Manideep-GitHub/Clap-Detector-EDL/powersupply1.eps.tex

% XCircuit output "D:/Desktop/Sem 6/EE344 - Electronics Design Lab/MON-PCP-2-2/powersupply1.eps.tex" for LaTeX input from D:/Desktop/Sem 6/EE344 - Electronics Design Lab/MON-PCP-2-2/powersupply1.eps.ps
\def\putbox#1#2#3{\makebox[0in][l]{\makebox[#1][l]{}\raisebox{\baselineskip}[0in][0in]{\raisebox{#2}[0in][0in]{#3}}}}
\def\rightbox#1{\makebox[0in][r]{#1}}
\def\centbox#1{\makebox[0in]{#1}}
\def\topbox#1{\raisebox{-\baselineskip}[0in][0in]{#1}}
\def\midbox#1{\raisebox{-0.5\baselineskip}[0in][0in]{#1}}
\begin{flushleft}
\epsfig{file=D:/Desktop/Sem 6/EE344 - Electronics Design Lab/MON-PCP-2-2/powersupply1.eps.ps}\\
% translate x=528 y=476 scale 0.38
\putbox{4.47in}{1.79in}{Vref}%
\end{flushleft}
