Manideep-GitHub/Clap-Detector-EDL/powersupply.PNG

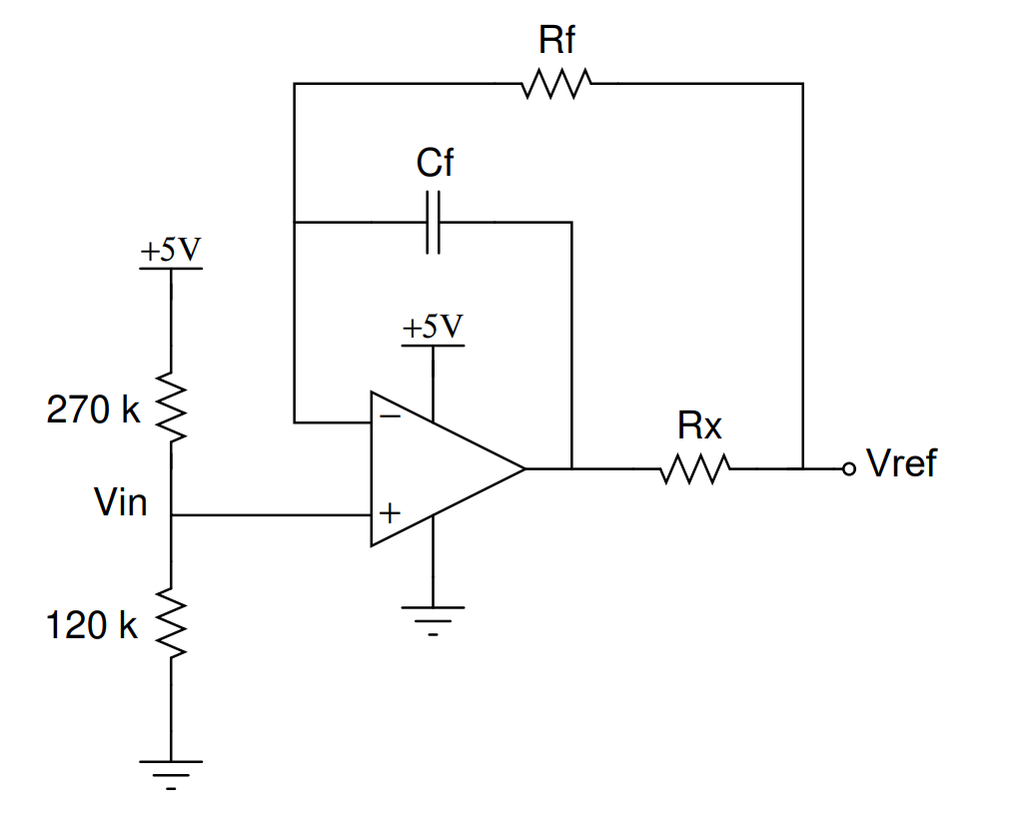
powersupply.PNG
