Manideep-GitHub/Clap-Detector-EDL/MON-PCP-2-2.pdf

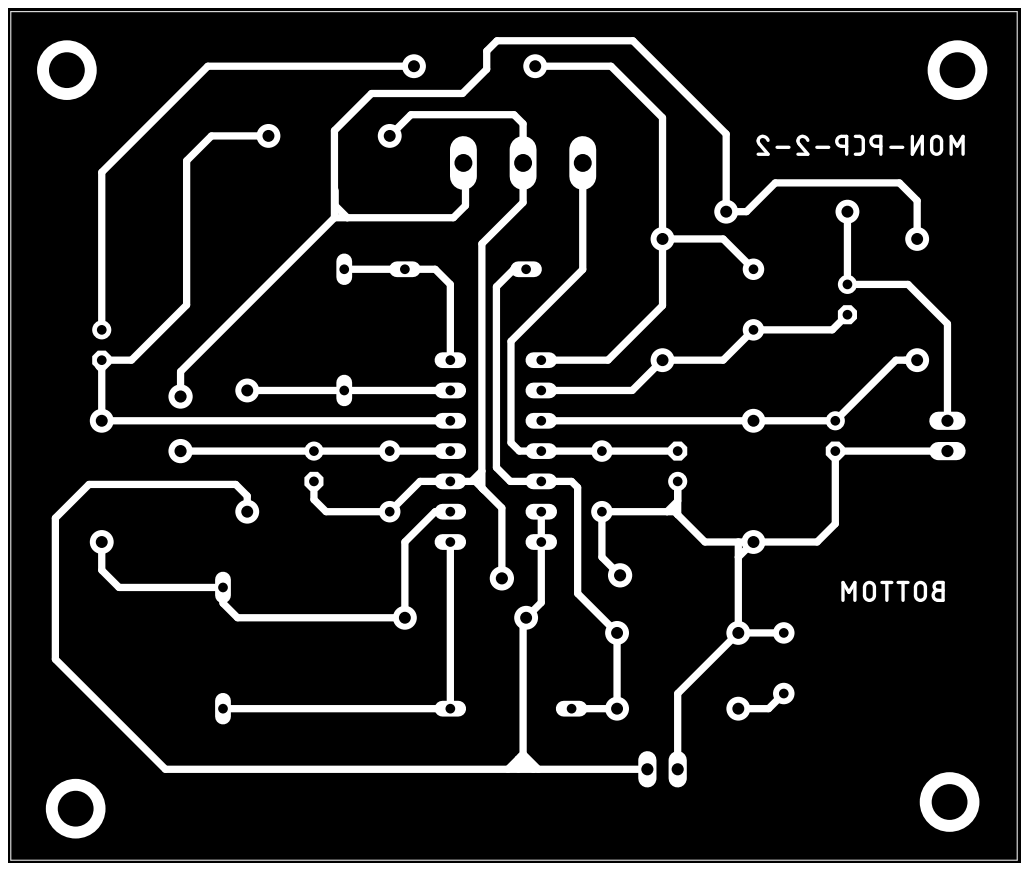
[picture p9: page 1]
