Manideep-GitHub/Clap-Detector-EDL/MON-PCP-2-2.brd

## EAGLE design MON-PCP-2-2.brd (2022-08-19)

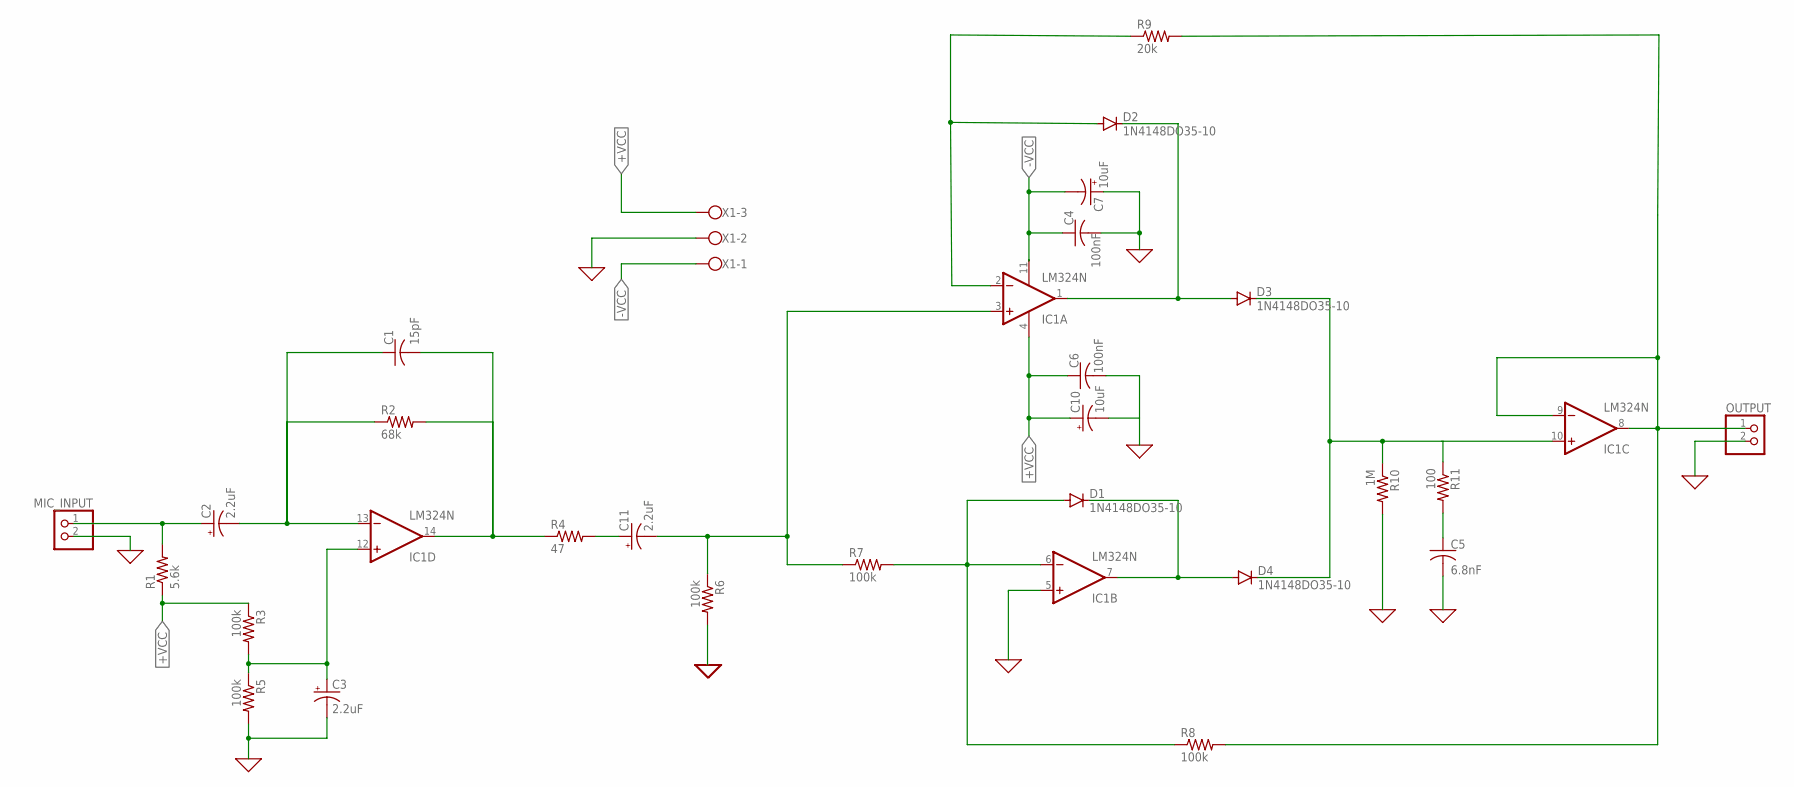
[picture p10: schematic MON-PCP-2-2.sch]

Parts:
C1: 15pF; C050-025X075
C2, C3, C11: 2.2uF; E2,5-7
C4, C6: 100nF; C050-025X075
C5: 6.8nF; C050-025X075
C7, C10: 10uF; E2,5-7
D1, D2, D3, D4: 1N4148DO35-10; DO35-10
IC1: LM324N; DIL14
MIC_INPUT: PINHD-1X2; 1X02
OUTPUT: PINHD-1X2; 1X02
R1: 5.6k; 0207/10
R2: 68k; 0207/10
R3, R5, R6, R7, R8: 100k; 0207/10
R4: 47; 0207/10
R9: 20k; 0207/10
R10: 1M; 0207/10
R11: 100; 0207/10
X1: W237-103

Connections:
0: C3.-, C4.2, C5.2, C6.2, C7.+, C10.-, IC1.5 (+IN), MIC_INPUT.2, OUTPUT.2, R5.2, R6.2, R10.2, X1.2
+VCC: C6.1, C10.+, IC1.4 (V+), R1.1, R3.1, X1.3
-VCC: C4.1, C7.-, IC1.11 (V-), X1.1
unnamed: D1.A, IC1.6 (-IN), R7.2, R8.1
unnamed: C3.+, IC1.12 (+IN), R3.2, R5.1
unnamed: C1.1, C2.-, IC1.13 (-IN), R2.1
unnamed: C11.+, R4.2
unnamed: C1.2, IC1.14 (OUT), R2.2, R4.1
unnamed: C11.-, IC1.3 (+IN), R6.1, R7.1
unnamed: D1.C, D4.A, IC1.7 (OUT)
unnamed: D2.C, D3.A, IC1.1 (OUT)
unnamed: D3.C, D4.C, IC1.10 (+IN), R10.1, R11.1
unnamed: C5.1, R11.2
unnamed: D2.A, IC1.2 (-IN), R9.1
VIN: C2.+, MIC_INPUT.1, R1.2
VOUT: IC1.8 (OUT), IC1.9 (-IN), OUTPUT.1, R8.2, R9.2

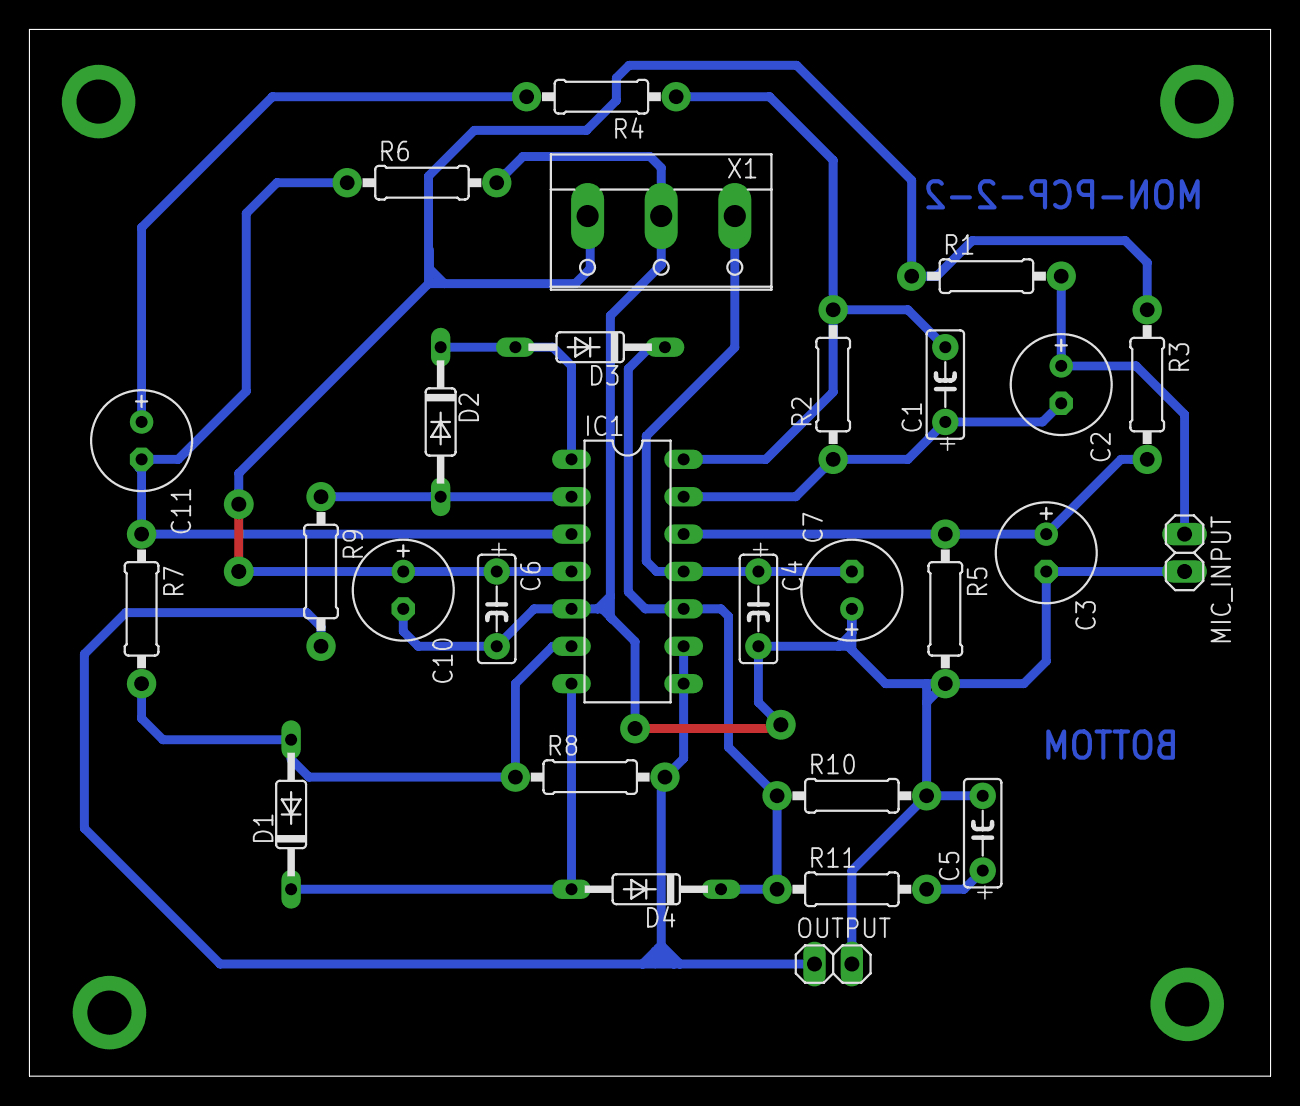
[picture p11: board MON-PCP-2-2.brd from above]

Board: 2 copper layers, 84.3 x 71.1 mm, 28 parts (0 on the bottom side), 16 nets.
